360nosc0pe/siglent_hardware/sds1202xe/pllconfig.png

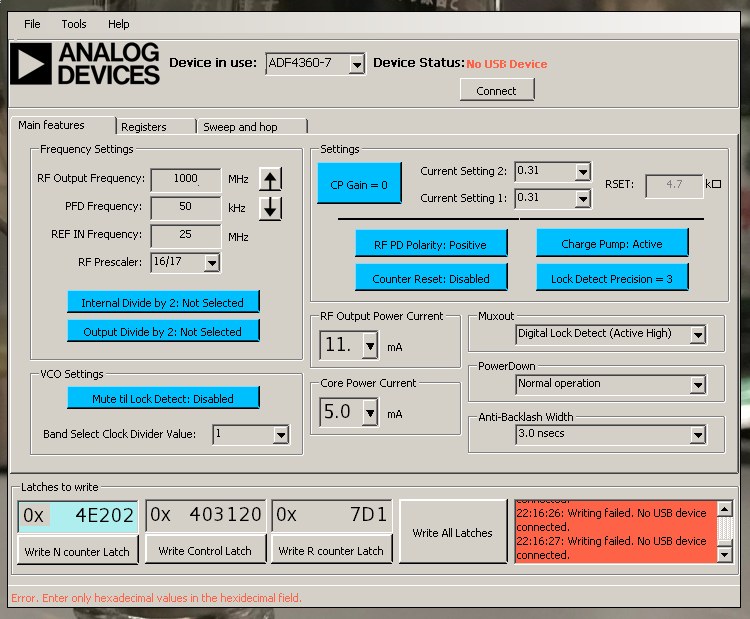
sds1202xe/pllconfig.png
