360nosc0pe/siglent_hardware/sds1202xe/siglent_AFE/AD8370-fbl.png

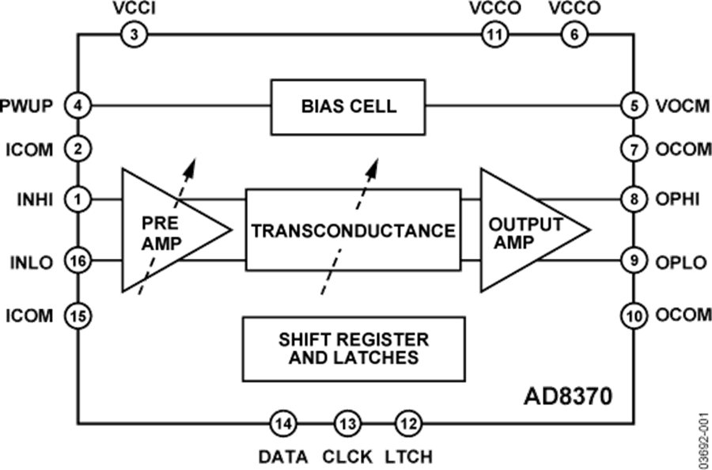
sds1202xe/siglent_AFE/AD8370-fbl.png
