360nosc0pe/siglent_hardware/sds1202xe/siglent_AFE/ADA4932-1-FBL.png

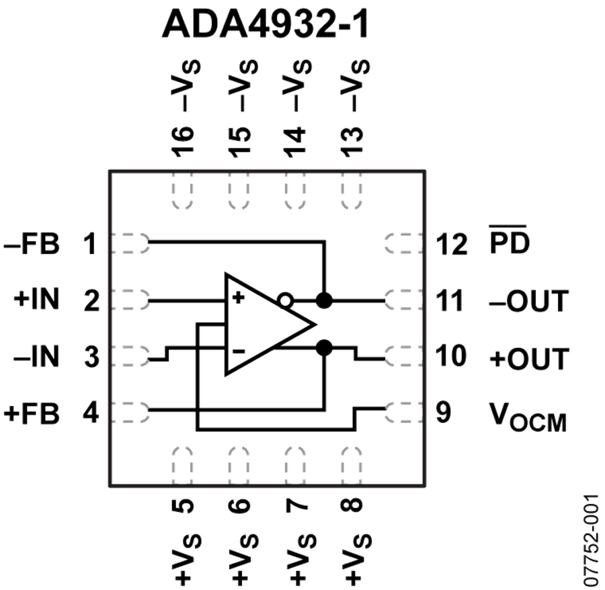
sds1202xe/siglent_AFE/ADA4932-1-FBL.png
