360nosc0pe/siglent_hardware/sds1104xe/block_diagram/block.pdf

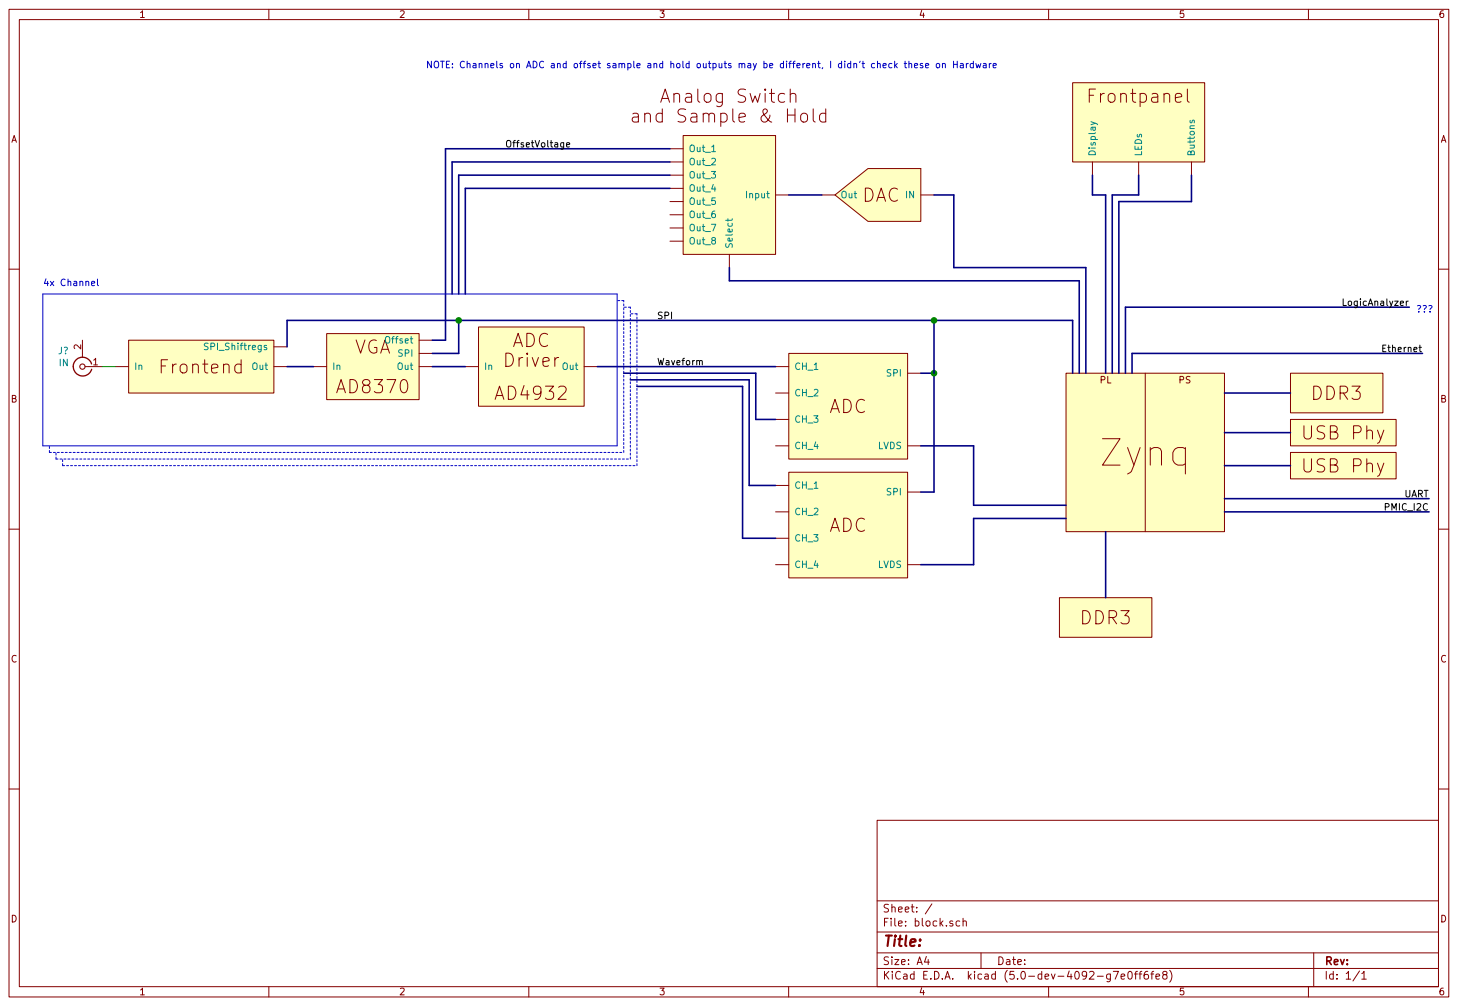
[picture p4: page 1]

UART PMIC_I2C Out DAC IN Analog Switch
and Sample & Hold

Id: 1/1 Title: File: block.sch Sheet: /
