360nosc0pe/siglent_hardware/sds1202xe/siglent_AFE/output.pdf

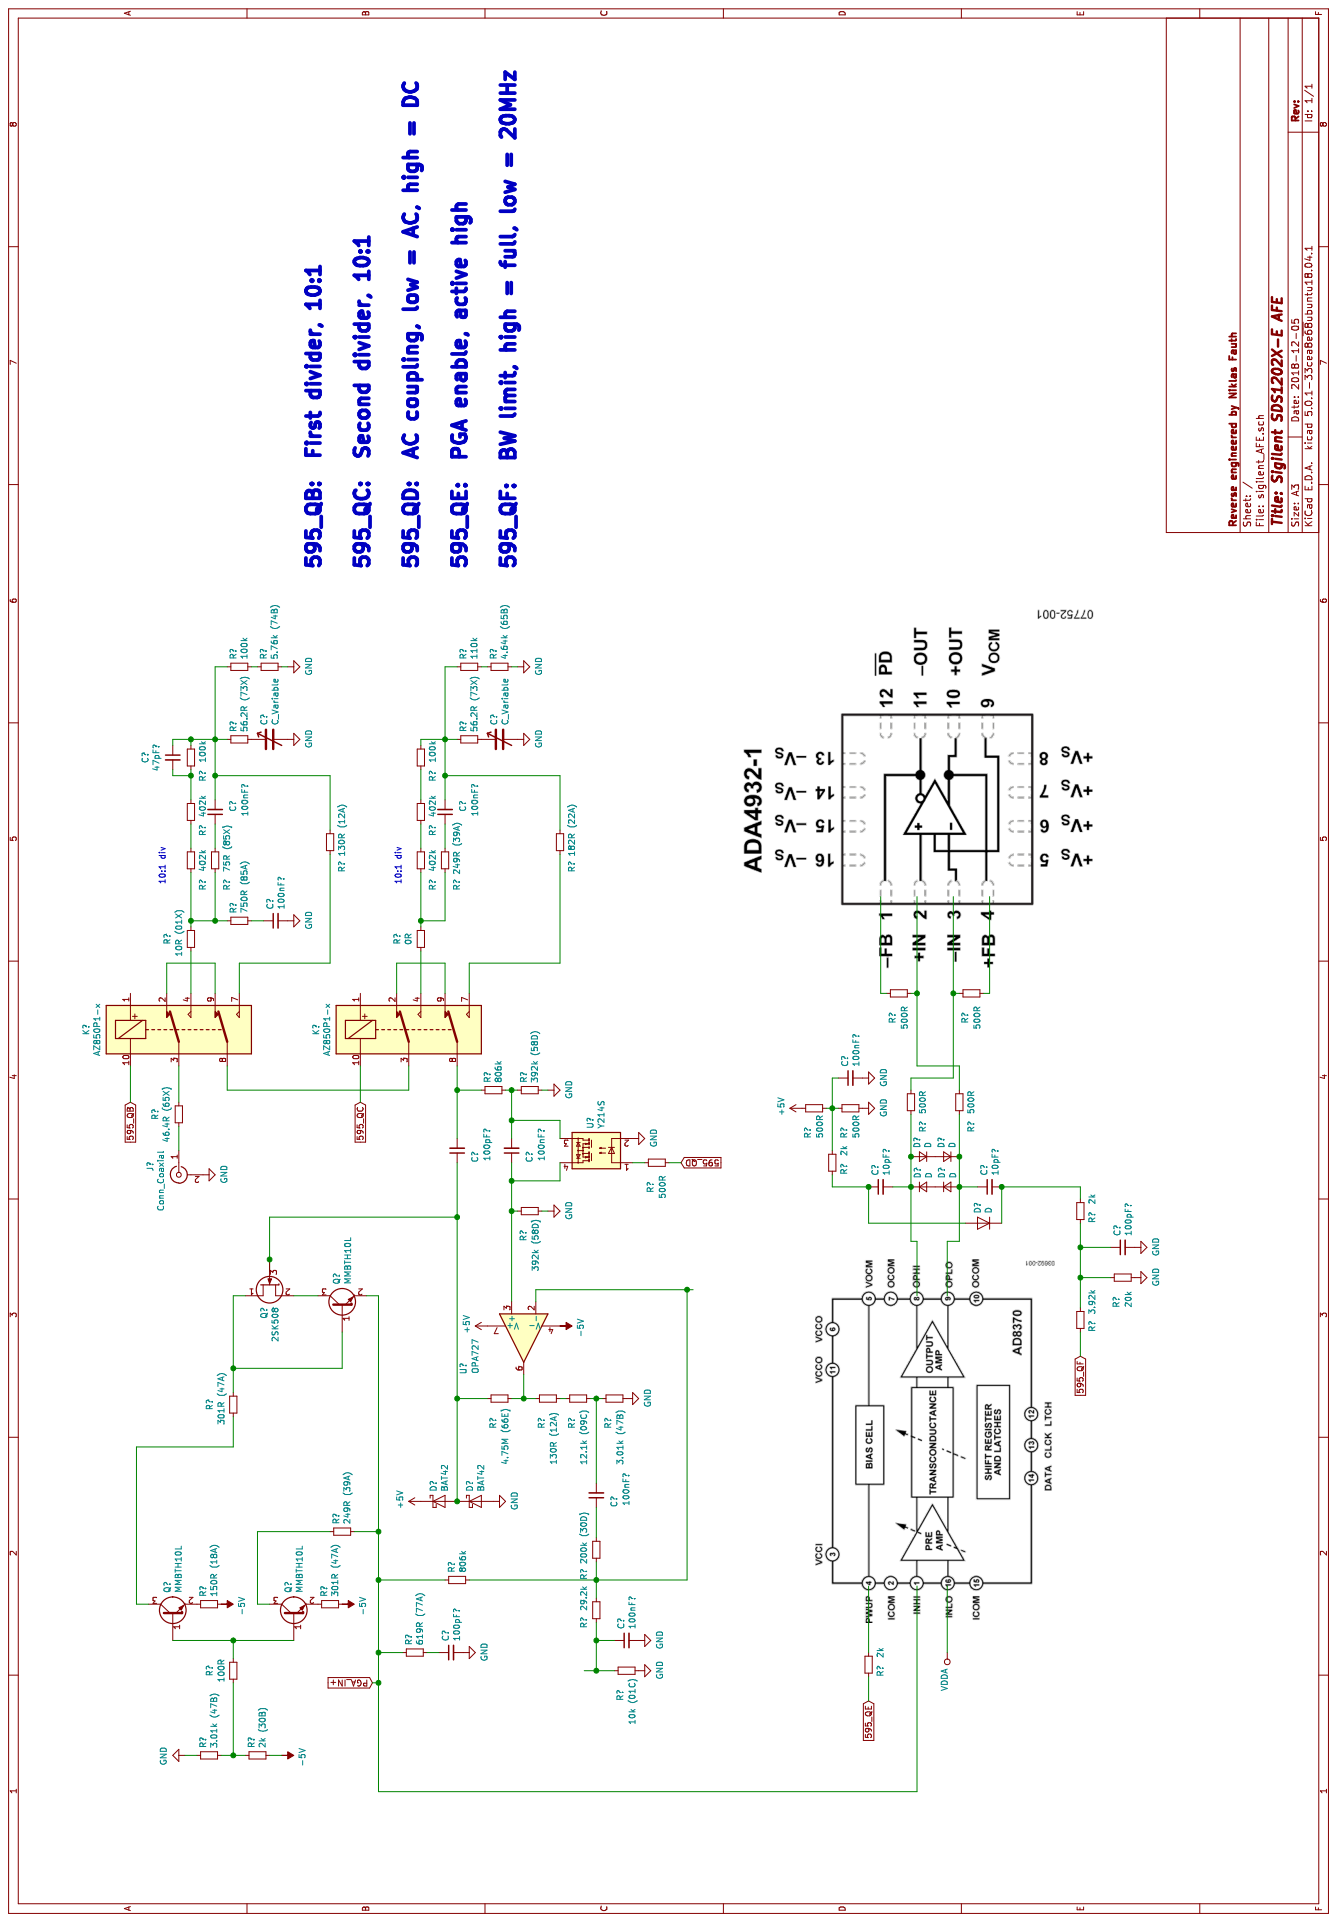
[picture p5: page 1]
