360nosc0pe/siglent_hardware/sds1104xe/block_diagram/block.sch

## KiCad design sds1104xe/block_diagram/block.sch (2018-08-05)

Schematic: block.sch

Parts:
U1: DAC
U10, U11: ADC
Ux4: VGA

Notes on the sheet:
4x Channel
NOTE: Channels on ADC and offset sample and hold outputs may be different, I didn't check these on Hardware
???
