360nosc0pe/siglent_hardware/(commit log)

2018-08-05 Initial import
    [block.sch]
2018-12-05 ADD: reverse engineering of the SDS1202 AFE, 74HV595 AFE function description
    [sigilent_AFE.kicad_pcb, sigilent_AFE.sch]
